Schimpfen/CCG_UPump/Housing/FullBoxSet.3mf

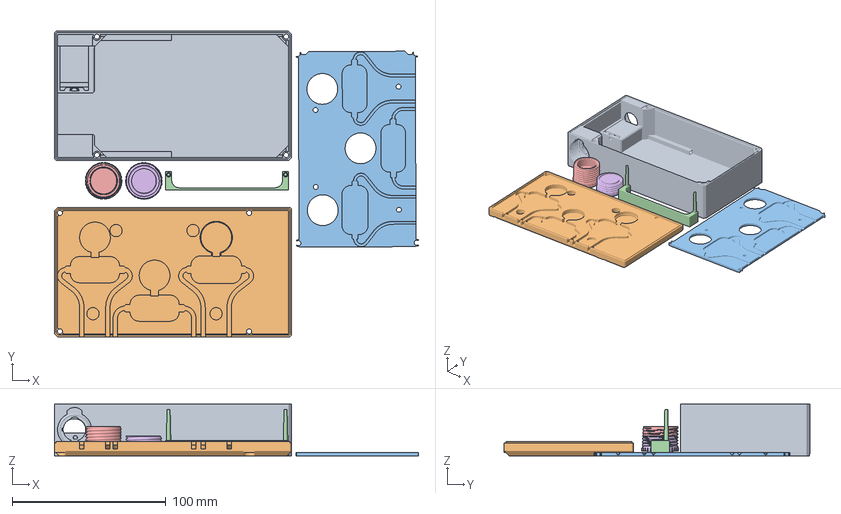
[picture p24: CAD file, 2025-12-09]
Housing/FullBoxSet.3mf
236.5 x 198.5 x 33.5 mm
bigbox.stl
Cover.stl
MidLayer.stl
batteryfix.stl
powerSc.stl
USBSc.stl
