Schimpfen/CCG_UPump/Housing/batteryfix.stl

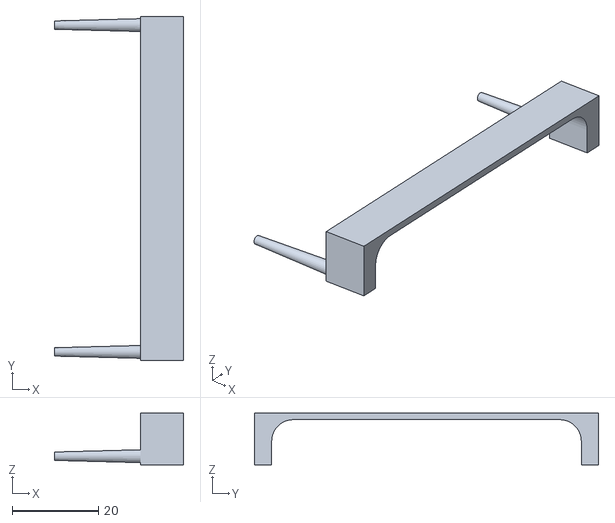
[picture p25: CAD file, 2025-12-09]
Housing/batteryfix.stl
30.0 x 80.0 x 12.0
