Schimpfen/CCG_UPump/PCBs/molex_fpc_4p.stl

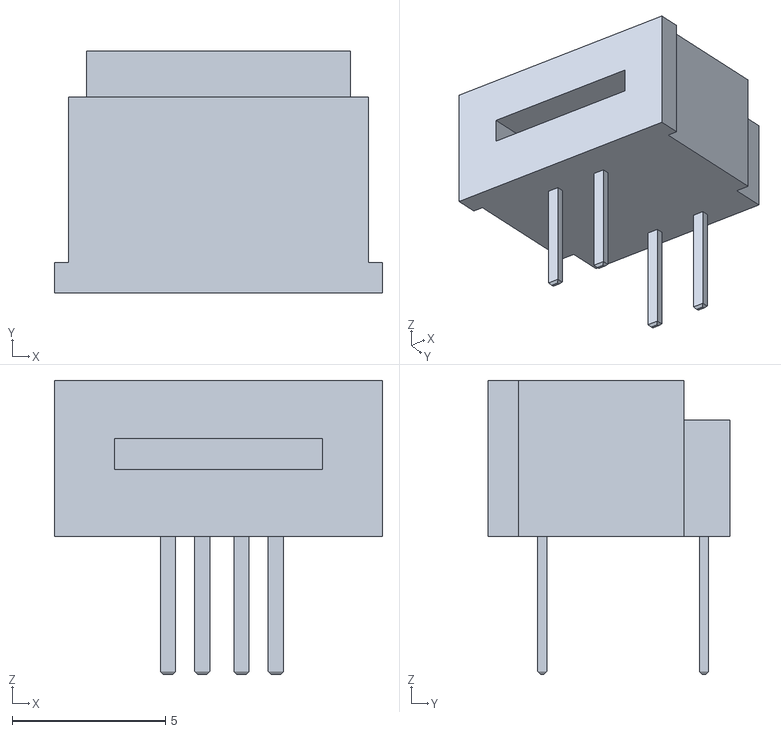
[picture p26: CAD file, 2025-12-09]
PCBs/molex_fpc_4p.stl
10.7 x 7.90 x 9.60
