Schimpfen/CCG_UPump/Housing/bigbox.stl

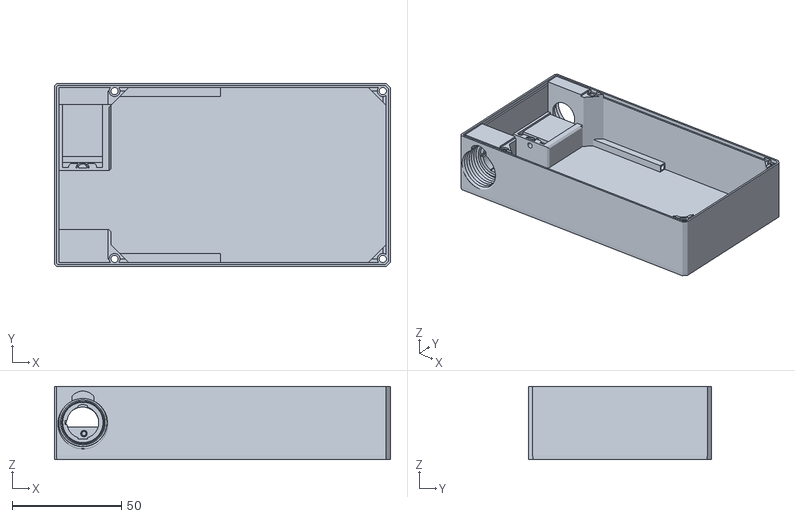
[picture p27: CAD file, 2025-12-09]
Housing/bigbox.stl
154.0 x 84.0 x 33.5
