Schimpfen/CCG_UPump/Housing/distance.stl

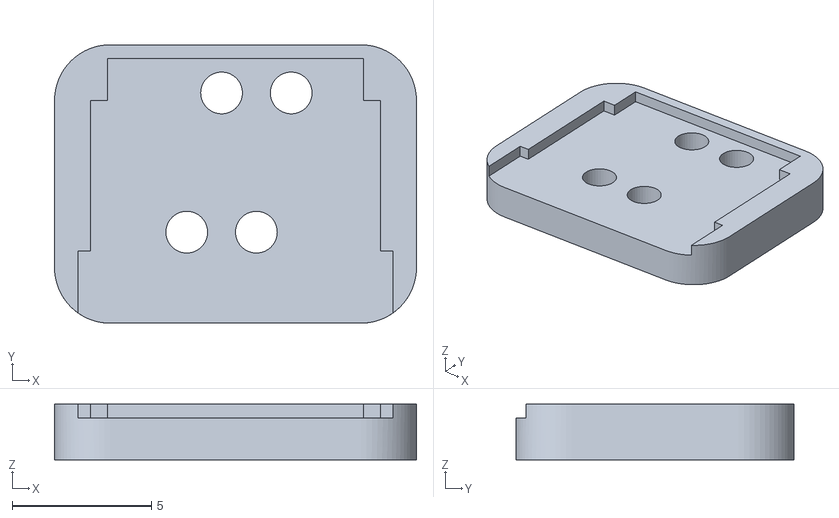
[picture p28: CAD file, 2025-12-09]
Housing/distance.stl
13.0 x 10.0 x 2.00
