Schimpfen/CCG_UPump/Housing/TPU Sealing.stl

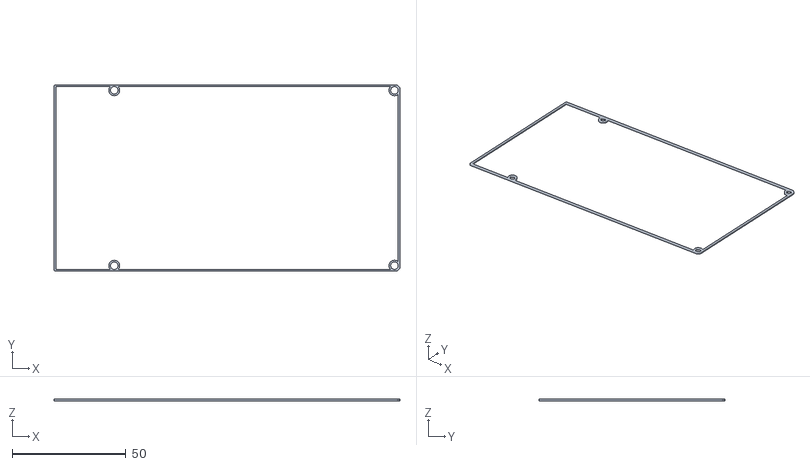
[picture p29: CAD file, 2025-12-09]
Housing/TPU Sealing.stl
151.8 x 81.8 x 1.00
