Schimpfen/CCG_UPump/Housing/USBSc.stl

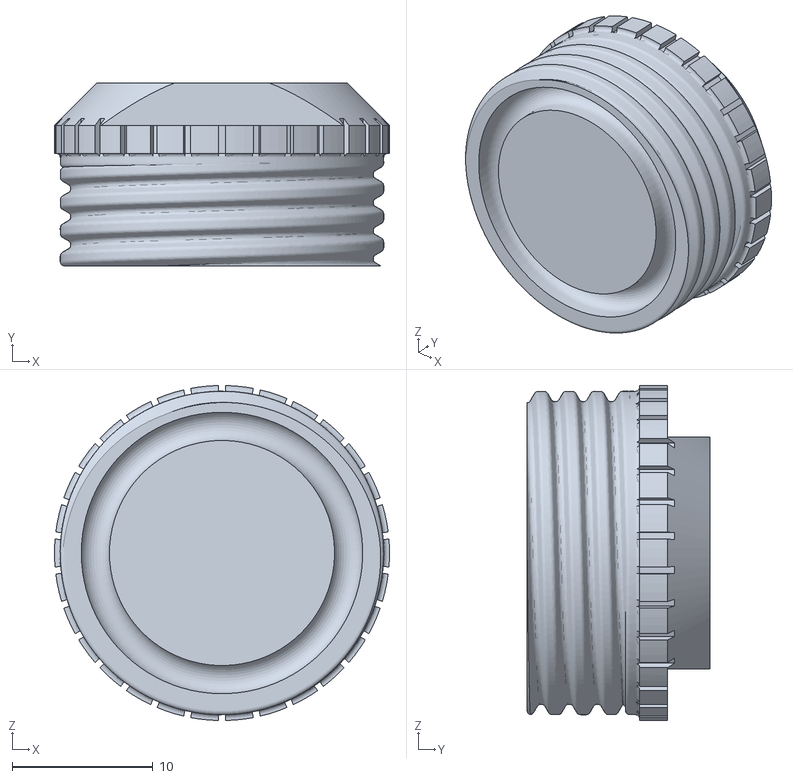
[picture p30: CAD file, 2025-12-09]
Housing/USBSc.stl
23.8 x 13.0 x 23.8
