Schimpfen/CCG_UPump/PCBs/esp32socket/esp32socket.kicad_pcb

## KiCad design PCBs/esp32socket/esp32socket.kicad_pcb (2025-12-09)

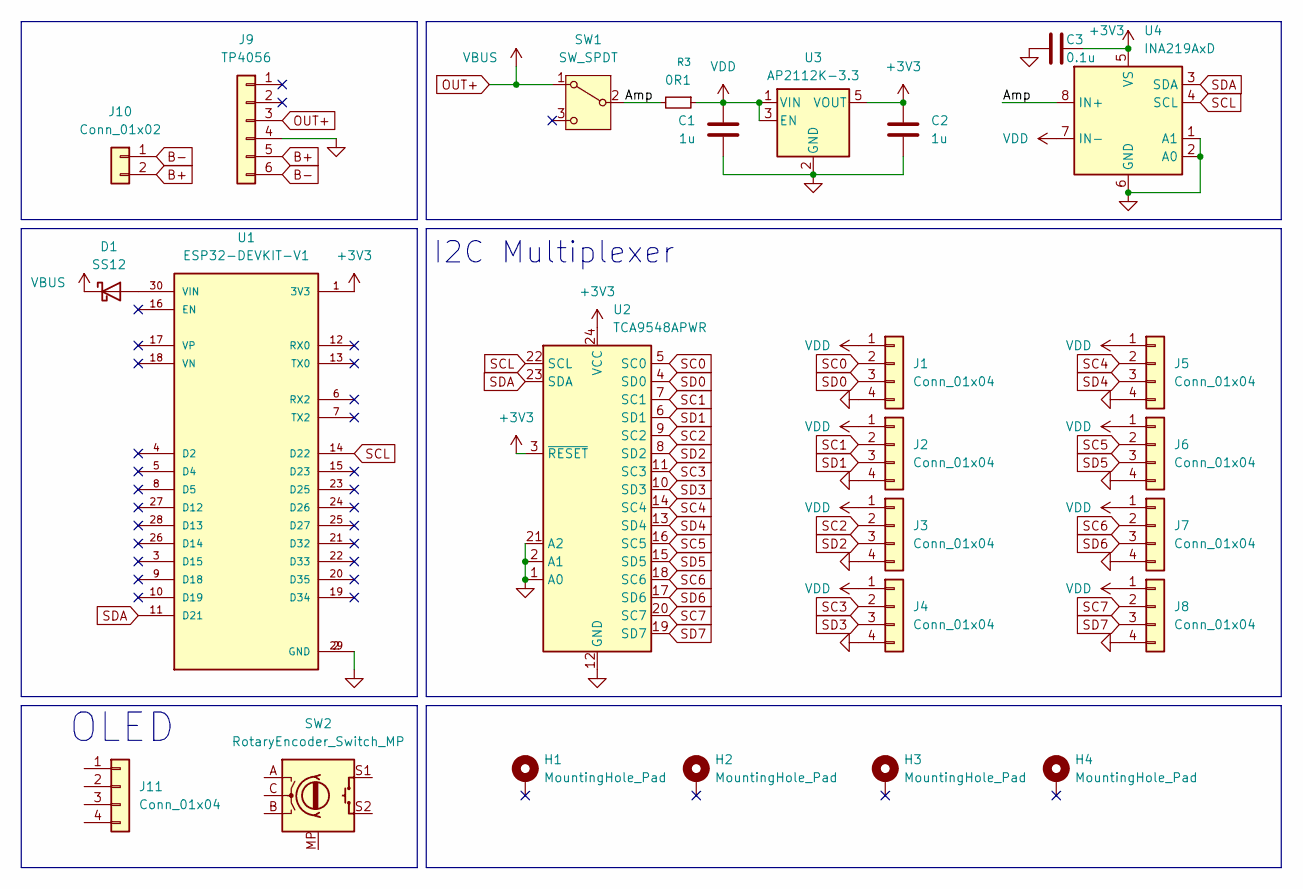
[picture p31: schematic esp32socket.kicad_sch, Mainboard for standalone micropumps]

Parts:
C1, C2: 1u; C_0805_2012Metric
C3: 0.1u; C_0805_2012Metric
D1: SS12; D_SMA
H1, H2, H3, H4: MountingHole_Pad; MountingHole_3.2mm_M3_DIN965_Pad
J1, J2, J3, J4, J5, J6, J7, J8: Conn_01x04; JST_XH_B4B-XH-A_1x04_P2.50mm_Vertical
J9: TP4056; TP4056-18650
J10: Conn_01x02; JST_PH_S2B-PH-K_1x02_P2.00mm_Horizontal
J11: Conn_01x04; PinHeader_1x04_P2.54mm_Vertical
R3: 0R1; R_1210_3225Metric
SW1: SW_SPDT; SW_Slide_SPDT_Straight_CK_OS102011MS2Q
SW2: RotaryEncoder_Switch_MP; RotaryEncoder_Alps_EC12E-Switch_Vertical_H20mm_CircularMoun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
U1: ESP32-DEVKIT-V1; MODULE_ESP32_DEVKIT_V1; PARTREV N/A
U2: TCA9548APWR; TCA9548A
U3: AP2112K-3.3; SOT-23-5
U4: INA219AxD; SOIC-8_3.9x4.9mm_P1.27mm

Connections:
+3V3: C2.2, C3.2, U1.1 (3V3), U2.3 (~RESET), U2.24 (VCC), U3.5 (VOUT), U4.5 (VS)
/Amp: R3.2, SW1.2 (B), U4.8 (IN+)
B+: J9.5, J10.2
B-: J9.6, J10.1
GND: C1.1, C2.1, C3.1, J1.4, J2.4, J3.4, J4.4, J5.4, J6.4, J7.4, J8.4, J9.4, U1.2 (GND), U1.29 (GND), U2.1 (A0), U2.2 (A1), U2.12 (GND), U2.21 (A2), U3.2 (GND), U4.1 (A1), U4.2 (A0), U4.6 (GND)
unnamed: D1.2 (A), U1.30 (VIN)
OUT+: D1.1 (K), J9.3, SW1.1 (A)
SC0: J1.2, U2.5 (SC0)
SC1: J2.2, U2.7 (SC1)
SC2: J3.2, U2.9 (SC2)
SC3: J4.2, U2.11 (SC3)
SC4: J5.2, U2.14 (SC4)
SC5: J6.2, U2.16 (SC5)
SC6: J7.2, U2.18 (SC6)
SC7: J8.2, U2.20 (SC7)
SCL: U1.14 (D22), U2.22 (SCL), U4.4 (SCL)
SD0: J1.3, U2.4 (SD0)
SD1: J2.3, U2.6 (SD1)
SD2: J3.3, U2.8 (SD2)
SD3: J4.3, U2.10 (SD3)
SD4: J5.3, U2.13 (SD4)
SD5: J6.3, U2.15 (SD5)
SD6: J7.3, U2.17 (SD6)
SD7: J8.3, U2.19 (SD7)
SDA: U1.11 (D21), U2.23 (SDA), U4.3 (SDA)
VDD: C1.2, J1.1, J2.1, J3.1, J4.1, J5.1, J6.1, J7.1, J8.1, R3.1, U3.1 (VIN), U3.3 (EN), U4.7 (IN-)

Notes on the sheet:
OLED
I2C Multiplexer

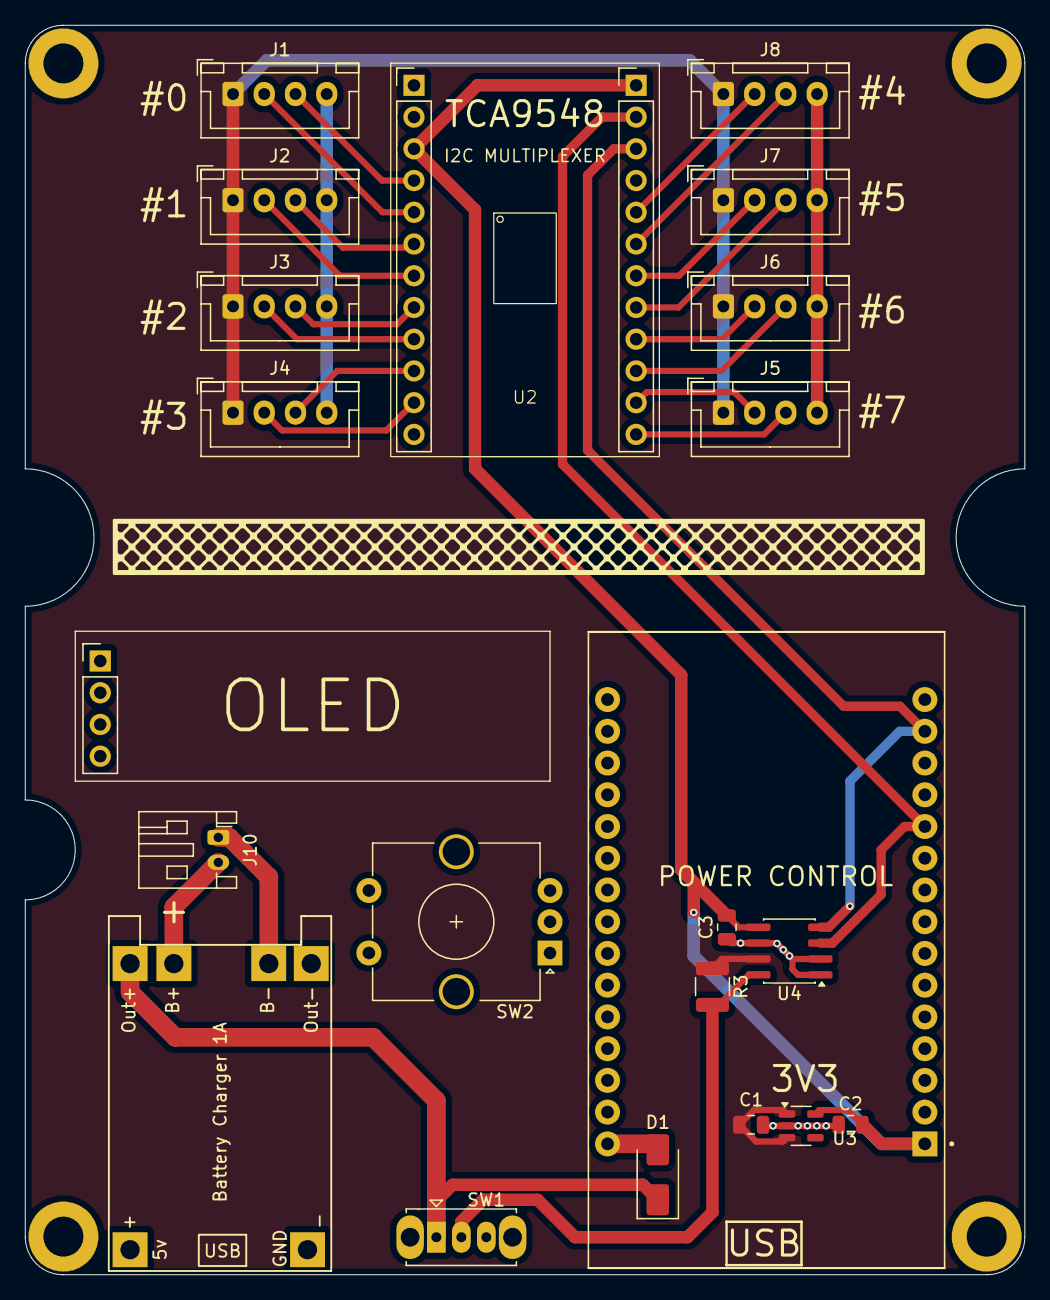
[picture p32: board esp32socket.kicad_pcb from above]

Board: 2 copper layers, 80.0 x 100.0 mm, 26 parts (0 on the bottom side), 26 nets.
